WilNeeley/Mega2560_Fan_Controller/doc/hw_design_process.md

<!-- Improved compatibility of back to top link: See: https://github.com/othneildrew/Best-README-Template/pull/73 -->

<!--
*** Hey there, welcome to my README File. Here's a couple helpful resources for writing up files like this:
*** - VS Code is super hepful for previewing files like this (CTRL + Shift + V).
*** - Alternatively, Notepad++ has a few plugins (e.g. MarkdownViewer++) that can preview files. 
*** - GitHub documentation (good for the basics): https://docs.github.com/en/get-started/writing-on-github/getting-started-with-writing-and-formatting-on-github/basic-writing-and-formatting-syntax
*** - Best-README-Template (lets you do sophisticated things): https://github.com/othneildrew/Best-README-template/blob/main/README.md
-->

<!-- Logo and Title Section -->
<br />
<div align="center">
  <!-- <a><img src="./img/board_populated_circuitmaker_rendering.jpg" alt="Logo" width="400" height="500"></a> -->
  <h3 align="center"><strong>
    Mega2560 Fan Controller <br />    
    Hardware Design Process
  </strong></h3>
  
  <p align="center">
    Wil Neeley
    <br />
    2025-05-22
  </p>
</div>

## References

[ATmega2560 Datasheet](https://ww1.microchip.com/downloads/aemDocuments/documents/OTH/ProductDocuments/DataSheets/ATmega640-1280-1281-2560-2561-Datasheet-DS40002211A.pdf)

[Noctua PWM Specifications White Paper](https://noctua.at/pub/media/wysiwyg/Noctua_PWM_specifications_white_paper.pdf)

[Intel 4-Wire PWM Controlled Fans](https://www.intel.com/content/dam/support/us/en/documents/intel-nuc/intel-4wire-pwm-fans-specs.pdf)
