WilNeeley/Mega2560_Fan_Controller/img/v1/board_v1_bare_pcbway_rendering_bottom.png

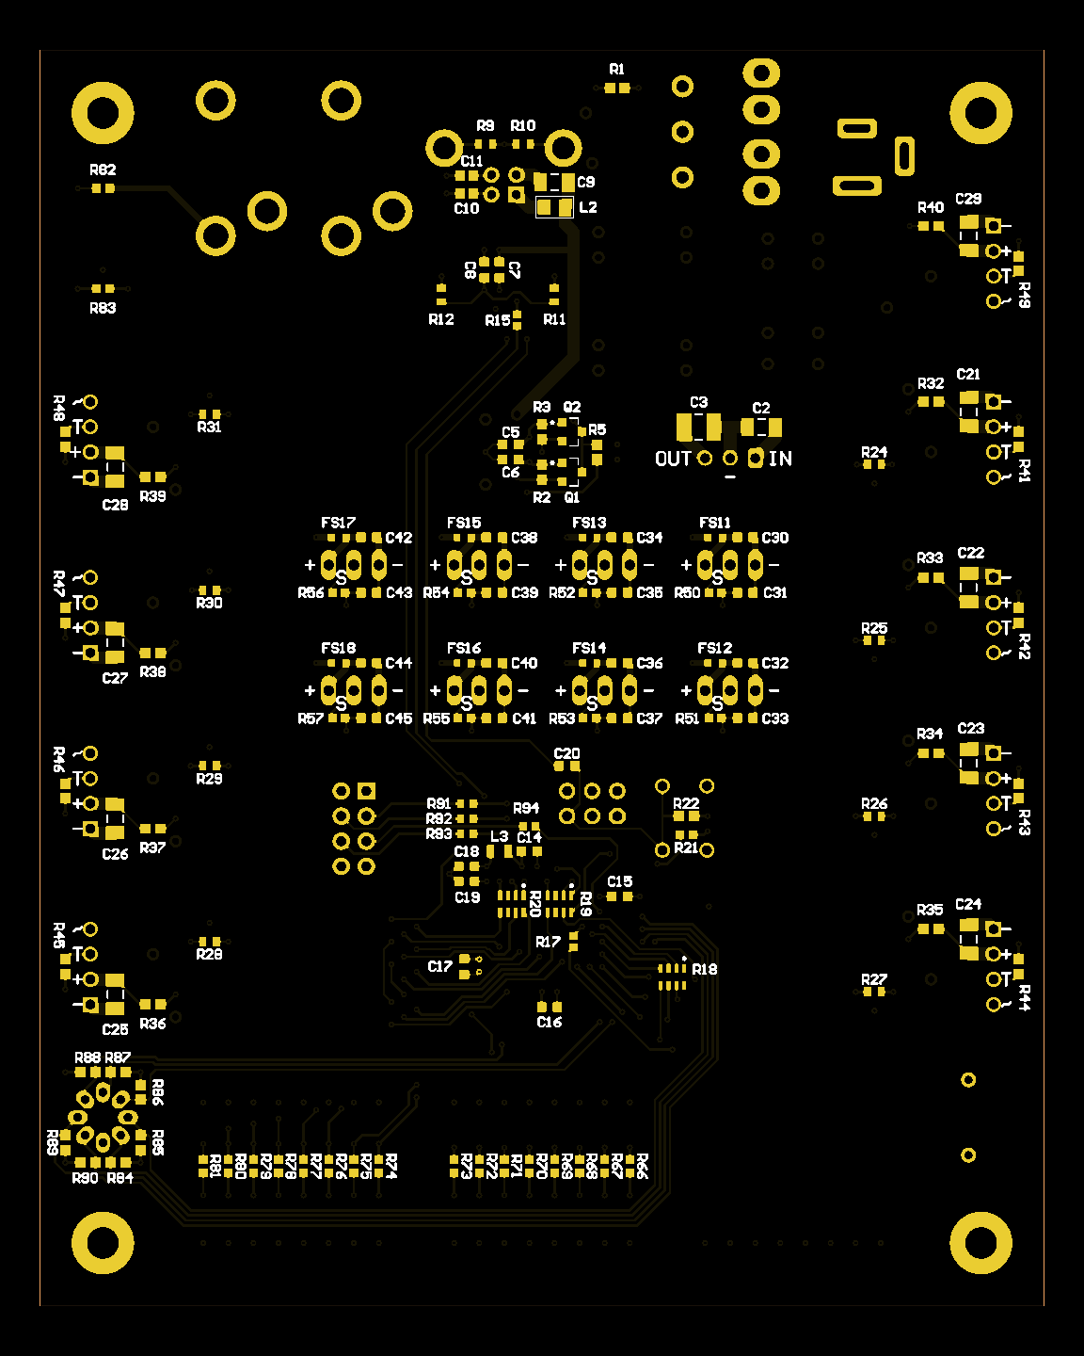
img/v1/board_v1_bare_pcbway_rendering_bottom.png
