WilNeeley/Mega2560_Fan_Controller/hw/v1/BOM - Mega2560 PWM Fan Controller v1.xlsx

Sheet: Summary
Parts | Unique | Type | Costs
On-Board Components
4 | 4 | Integrated Circuits | $26.39
90 | 7 | Resistors | $3.41
45 | 6 | Capacitors | $4.22
5 | 5 | Inductors, Crystals, and Oscillators | $2.23
49 | 4 | Diodes | $8.90
11 | 2 | Transistors | $11.03
27 | 10 | Connectors and Buttons | $26.75
19 | 4 | Miscellaneous | $7.15
250 | 42 | Total (no shipping) | $90.06
Off-Board Components
33 | 3 | Off-Board Components | $21.04
33 | 3 | Total (no shipping) | $21.04

Sheet: On-Board Components
Quantity | Reference Designator | Value | Package | Description | Manufacturer | Part # | AEC-Q? | RoHS? | Tmin (°C) | Tmax (°C) | Source | Source Part # | Cost | Extended | Notes
Integrated Circuits
1 | U1 | 5V | 3-SIP | NON-ISOLATED POL MODULE DC DC CO | GAPTEC | LME78_05-1.0 | Other (no) | Yes | -40 | 85 | Digi-Key | 3182-LME78_05-1.0-ND | $4.11 | $4.11
1 | U2 |  | 8-TSSOP | IC OR CTRLR SRC SELECT 8TSSOP | Texas Instruments | TPS2113PWR | No | Yes | -40 | 85 | Digi-Key | 296-46374-1-ND | $2.64 | $2.64
1 | U3 |  | 20-SSOP | IC USB SERIAL FULL UART 20SSOP | FTDI | FT231XS-R | No | Yes | -40 | 85 | Digi-Key | 768-1129-1-ND | $2.34 | $2.34
1 | U4 |  | 100-TQFP | IC MCU 8BIT 256KB FLASH 100TQFP | Microchip | ATMEGA2560-16AU | No | Yes | -40 | 85 | Digi-Key | ATMEGA2560-16AU-ND | $17.30 | $17.30
4 | Total | 4 | Unique Parts |  |  |  |  |  |  |  |  |  |  | $26.39
Resistors
1 | R23 | 1MEG | 0603 | RES SMD 1M OHM 1% 1/10W 0603 | Vishay Dale | CRCW06031M00FKEA | 200 | Yes | -55 | 155 | Digi-Key | 541-1.00MHCT-ND | $0.10 | $0.10
1 | R7 | 47k | 0603 | RES SMD 47K OHM 1% 1/10W 0603 | Vishay Dale | CRCW060347K0FKEA | 200 | Yes | -55 | 155 | Digi-Key | 541-47.0KHCT-ND | $0.10 | $0.10
32 | R1-R6, R22, R32-R49, R84-R90 | 10k | 0603 | RES SMD 10K OHM 1% 1/10W 0603 | Vishay Dale | CRCW060310K0FKEA | 200 | Yes | -55 | 155 | Digi-Key | 541-10.0KHCT-ND | $0.03 | $0.99
36 | R8, R21, R50-83 | 3k | 0603 | RES SMD 3K OHM 5% 1/10W 0603 | Vishay Dale | CRCW06033K00JNEA | 200 | Yes | -55 | 155 | Digi-Key | 541-3.0KGCT-ND | $0.03 | $1.04
12 | R9-R12, R24-R31 | 1.5k | 0603 | RES SMD 1.5K OHM 1% 1/10W 0603 | Vishay Dale | CRCW06031K50FKEA | 200 | Yes | -55 | 155 | Digi-Key | 541-1.50KHCT-ND | $0.03 | $0.37
3 | R18-R20 | 1k (x4) | 1206 (0603x4), Convex | RES ARRAY 4 RES 1K OHM 1206 | Bourns | CAY16-102J4LF | No | Yes | -55 | 125 | Digi-Key | CAY16-102J4LFCT-ND | $0.10 | $0.30
5 | R13-R17 | 27 | 0603 | RES SMD 27 OHM 1% 1/10W 0603 | Vishay Dale | CRCW060327R0FKEA | 200 | Yes | -55 | 155 | Digi-Key | 541-27.0HCT-ND | $0.10 | $0.50
0 | R91-R94 | DNI | 0603 | PLACEHOLDER | --- | --- | --- | --- | --- | --- | --- | --- | $0.00 | $0.00
90 | Total | 7 | Unique Parts |  |  |  |  |  |  |  |  |  |  | $3.41
Capacitors
1 | C1 | 680uF / 35V | 12.5mm (D) x 14mm (H) | CAP ALUM 680UF 20% 35V SMD | Panasonic | EEV-FK1V681Q | 200 | Yes | -55 | 105 | Digi-Key | PCE3465CT-ND | $1.45 | $1.45
2 | C3, C4 | 22uF / 16V | 1210 | CAP CER 22UF 16V X5R 1206 | Samsung | CL31A226MOCLNNC | No | Yes | -55 | 85 | Digi-Key | 1276-2728-1-ND | $0.23 | $0.46
11 | C2, C9, C20-C29 | 4.7uF / 50V | 1206 | CAP CER 4.7UF 50V X5R 1206 | Murata | GRM319R61H475KA12D | No | Yes | -55 | 85 | Digi-Key | 490-14384-1-ND | $0.13 | $1.47
27 | C5-C8, C14-C20, C30-C45 | 0.1uF / 16V+ | 0603 | CAP CER 0.1UF 50V X7R 0603 | Kemet | C0603C104K5RACTU | No | Yes | -55 | 125 | Digi-Key | 399-C0603C104K5RACTUCT-ND | $0.02 | $0.43
2 | C12-C13 | 18pF | 0603 | CAP CER 18PF 100V C0G/NP0 0603 | Murata | GCM1885C2A180JA16D | 200 | Yes | -55 | 125 | Digi-Key | 490-14762-1-ND | $0.10 | $0.20
2 | C10-C11 | 47pF | 0603 | CAP CER 47PF 100V C0G/NP0 0603 | Murata | GCM1885C2A470JA16J | 200 | Yes | -55 | 125 | Digi-Key | 490-GCM1885C2A470JA16JCT-ND | $0.10 | $0.20
45 | Total | 6 | Unique Parts |  |  |  |  |  |  |  |  |  |  | $4.22
Inductors, Crystals, and Oscillators
1 | BZ1 | 4kHz | 0.48" Dia. PTH | BUZZER PIEZO 3V 12.2MM TH | TDK Corporation | PS1240P02BT | No | Yes | -10 | 70 | Digi-Key | 445-2525-1-ND | $0.55 | $0.55
1 | L1 | 47uH / 2.95A | 12.5x12.5mm | FIXED IND 47UH 2.95A 71.9MOHM SM | Eaton | DR127-470-R | No | Yes | -40 | 125 | Digi-Key | 283-DR127-470-RCT-ND | $0.82 | $0.82
1 | L2 | 40 @ 100MHz | 0805 | FERRITE BEAD 40 OHM 0805 1LN | Laird | MI0805K400R-10 | No | Yes | -40 | 125 | Digi-Key | 240-2389-1-ND | $0.20 | $0.20
1 | L3 | 10uH | 0805 | FIXED IND 10UH 500MA 300MOHM SMD | TDK Corporation | MLZ2012N100LT000 | No | Yes | -55 | 125 | Digi-key | 445-6762-1-ND | $0.10 | $0.10
1 | X1 | 16MHz |  | CRYSTAL 16.0000MHZ 18PF SMD | Abracon | ABM3-16.000MHZ-D2Y-T | No | Yes | -40 | 85 | Digi-Key | 535-10638-1-ND | $0.56 | $0.56
5 | Total | 5 | Unique Parts |  |  |  |  |  |  |  |  |  |  | $2.23
Diodes
10 | D1-D10 | 12V | DO-214AA | TVS DIODE 12VWM 19.9VC DO214AA | Littelfuse | SMBJ12A | No | Yes | -65 | 150 | Digi-Key | SMBJ12ALFCT-ND | $0.21 | $2.15
21 | D11-D30, D49 | Green | 0603 | LED GREEN DIFFUSED 0603 SMD | Wurth Elektronik | 150060VS55040 | No | Yes | -40 | 85 | Digi-Key | 732-12017-1-ND | $0.17 | $3.63
9 | D31-D39 | Yellow | 0603 | LED YELLOW DIFFUSED 0603 SMD | Wurth Elektronik | 150060YS55040 | No | Yes | -40 | 85 | Digi-Key | 732-12018-1-ND | $0.17 | $1.56
9 | D40-D48 | Red | 0603 | LED RED DIFFUSED 0603 SMD | Wurth Elektronik | 150060SS55040 | No | Yes | -40 | 85 | Digi-Key | 732-12016-1-ND | $0.17 | $1.56
49 | Total | 4 | Unique Parts |  |  |  |  |  |  |  |  |  |  | $8.90
Transistors
9 | K1-K9 |  | 6-SOP | SSR RELAY SPST-NO 700MA 0-60V | Toshiba | TLP170AM(TPL,E | No | Yes | -40 | 85 | Digi-key | 264-TLP170AM(TPLECT-ND | $1.18 | $10.65
2 | Q1-Q2 |  | SOT-23-3 | MOSFET N-CH 100V 170MA SOT23-3 | Diodes Inc. | BSS123-7-F | No | Yes | -55 | 150 | Digi-Key | BSS123-FDICT-ND | $0.19 | $0.38
11 | Total | 2 | Unique Parts |  |  |  |  |  |  |  |  |  |  | $11.03
Connectors and Buttons
1 | J1 | 24V / 5A | 5.5x2.1mm barrel, PTH RA | CONN PWR JACK 2.1X5.5MM SOLDER | Wurth Elektronik | 694106301002 | No | Yes | -40 | 85 | Digi-Key | 732-5930-ND | $0.92 | $0.92
1 | J2 | USB 2.0 | USB-B, PTH, RA | CONN RCPT USB2.0 TYPEB 4POS R/A | Amphenol | 61729-0010BLF | No | Yes | -55 | 85 | Digi-Key | 609-1039-ND | $1.12 | $1.12
2 | J3, J4 | 12V / 1A | 3.5mm Mono, RA | CONN JACK MONO 3.5MM R/A | CUI Devices | MJ-3536NG | No | Yes | -40 | 85 | Digi-Key | CP-3536NG-ND | $1.27 | $2.54
0 | J5 |  | 6-PTH | CONN HEADER VERT 6POS 2.54MM | Harwin | M20-9980346 | No | Yes | -40 | 105 | Digi-Key | 952-2121-ND | $0.24 | $0.00
0 | J6 |  | 8-PTH | CONN HEADER VERT 8POS 2.54MM | Harwin | M20-9980446 | No | Yes | -40 | 105 | Digi-Key | 952-2123-ND | $0.31 | $0.00
9 | J11-J19 |  | 4-SIP | CONN HEADER VERT 4POS 2.54MM | Molex | 47053-1000 | No | Yes |  |  | Digi-Key | WM4330-ND | $0.41 | $3.73
8 | J21-J28 |  | 3-SIP | CONN HEADER VERT 3POS 2.54MM | Molex | 70543-0002 | No | Yes | -40 | 105 | Digi-Key | WM4801-ND | $0.93 | $7.44
1 | SW1 | 30V / 4A | 3-SIP | SWITCH SLIDE 1-POLE ON - ON | Knitter-Switch | MFP 106 D | No | Yes | -10 | 60 | Digi-Key | 3746-MFP106D-ND | $3.30 | $3.30
1 | SW2 | 30V / 50mA | 4-DIP | SWITCH TACTILE SPST-NO 0.05A 24V | TE Connectivity | 1825910-2 | No | Yes | -35 | 85 | Digi-Key | 450-1649-ND | $0.15 | $0.15
2 | SW3-SW4 | 20V / 100mA | 16-SOP | SWITCH SLIDE DIP SPST 0.1A 20V | CTS Electrocomponents | 219-8LPST | No | Yes | -55 | 85 | Digi-Key | CT2198LPST-ND | $1.00 | $2.00
1 | SW5 | 24V / 500mA |  | SWITCH ROTARY 7POS 500MA 24V | C&K Components | RM100772BCB | No | Yes | -40 | 85 | Digi-Key | CKN10691-ND | $4.62 | $4.62
1 | Cap for SW5 |  |  | RM SERIES CAP-TYPE B-BLK | C&K Components | 297F02000 | No | Yes | -40 | 85 | Digi-Key | CKN10707-ND | $0.92 | $0.92
27 | Total | 10 | Unique Parts |  |  |  |  |  |  |  |  |  |  | $26.75
Miscellaneous
1 | FS1 |  | Mini (ATM) | FUSE BLOCK BLADE 500V 20A PCB | Keystone | 3544-2 | No | Yes | -55 | 145 | Digi-Key | 36-3544-2-ND | $0.80 | $0.80
1 | Fuse for FS1 | 3A | Mini (ATM) | FUSE AUTOMOTIVE 3A 32VDC BLADE | Littelfuse | 0297003.WXT | Auto (no) | Yes | -40 | 125 | Digi-Key | 0297003.WXT-ND | $0.32 | $0.32
9 | FS2-FS10 | 0.5A | 1206 | FUSE BOARD MNT 500MA 63VDC 1206 | Bourns | SF1206S050-2 | No | Yes | -20 | 105 | Digi-Key | SF-1206S050-2CT-ND | $0.47 | $4.19
8 | FS11-FS18 | 10mA | 0603 | PTC RESET FUSE 60V 10MA 0603 | Bel Fuse | 0ZCM0001FF2G | 200 | Yes | -40 | 85 | Digi-Key | 5923-0ZCM0001FF2GCT-ND | $0.23 | $1.84
19 | Total | 4 | Unique Parts |  |  |  |  |  |  |  |  |  |  | $7.15
Selection Options
 |  |  |  |  |  |  | 100 | Yes
 |  |  |  |  |  |  | 101 | Exempt
 |  |  |  |  |  |  | 200 | ???
 |  |  |  |  |  |  | Aero. (no) | No
 |  |  |  |  |  |  | Auto (no)
 |  |  |  |  |  |  | IPXX (no)
 |  |  |  |  |  |  | Mili. (no)
 |  |  |  |  |  |  | Other (no)
 |  |  |  |  |  |  | No

Sheet: Off-Board Components
Quantity | Value | Package | Description | Manufacturer | Part # | AEC-Q200? | RoHS? | Tmin (°C) | Tmax (°C) | Source | Source Part # | Cost | Extended
1 |  |  | AC/DC WALL MOUNT ADAPTER 12V 36W | Mean Well | GST36U12-P1J | No | Yes | -30 | 70 | Digi-Key | 1866-2135-ND | $17.02 | $17.02
8 |  |  | Housings for J20-J27 Mates | Molex | 0050579403 | No | Yes | -40 | 105 | Digi-Key | WM2901-ND | $0.21 | $1.68
24 |  |  | Contacts for J20-J27 Mates | Molex | 0016020082 | No | Yes | -40 | 105 | Digi-Key | WM9138CT-ND | $0.10 | $2.34
33 | Total |  | 3 | Unique Parts |  |  |  |  |  |  |  |  | $21.04
Selection Options
 |  |  |  |  |  | 100 | Yes
 |  |  |  |  |  | 101 | Exempt
 |  |  |  |  |  | 200 | ???
 |  |  |  |  |  | Aero. (no) | No
 |  |  |  |  |  | Auto (no)
 |  |  |  |  |  | IPXX (no)
 |  |  |  |  |  | Mili. (no)
 |  |  |  |  |  | Other (no)
 |  |  |  |  |  | No
