WilNeeley/Mega2560_Fan_Controller/fw/FW_GETTING_STARTED.md

<!-- Improved compatibility of back to top link: See: https://github.com/othneildrew/Best-README-Template/pull/73 -->

<!--
*** Hey there, welcome to my RADME File. Here's a couple helpful resources for writing up files like this:
*** - VS Code is super hepful for previewing files like this (CTRL + Shift + V).
*** - Alternatively, Notepad++ has a few plugins (e.g. MarkdownViewer++) that can preview files. 
*** - GitHub documentation (good for the basics): https://docs.github.com/en/get-started/writing-on-github/getting-started-with-writing-and-formatting-on-github/basic-writing-and-formatting-syntax
*** - Best-README-Template (lets you do sophisticated things): https://github.com/othneildrew/Best-README-template/blob/main/README.md
-->

<!-- Logo and Title Section -->
<br />
<div align="center">
  
  <h3 align="center"><strong>
	Mega2560 Fan Controller
	<br />
	Hardware Documentation
	</strong>
  </h3>
  
  <p align="center">
    Wil Neeley
	<br />
	2025-05-12
	Board Version v1
  </p>
</div>

<!-- TABLE OF CONTENTS -->
<details>
  <summary>Table of Contents</summary>
  <ol>
    <li>
      <a href="#about-the-project">About The Project</a>
      <ul>
        <li><a href="#built-with">Built With</a></li>
      </ul>
    </li>
    <li>
      <a href="#getting-started">Getting Started</a>
      <ul>
        <li><a href="#prerequisites">Prerequisites</a></li>
        <li><a href="#installation">Installation</a></li>
      </ul>
    </li>
    <li><a href="#usage">Usage</a></li>
    <li><a href="#roadmap">Roadmap</a></li>
    <li><a href="#contributing">Contributing</a></li>
    <li><a href="#license">License</a></li>
    <li><a href="#contact">Contact</a></li>
    <li><a href="#acknowledgments">Acknowledgments</a></li>
  </ol>
</details>

<!-- ABOUT THE PROJECT -->
## About The Project

[![Product Name Screen Shot][product-screenshot]](https://example.com)

There are many great README templates available on GitHub; however, I didn't find one that really suited my needs so I created this enhanced one. I want to create a README template so amazing that it'll be the last one you ever need -- I think this is it.

Here's why:
* Your time should be focused on creating something amazing. A project that solves a problem and helps others
* You shouldn't be doing the same tasks over and over like creating a README from scratch
* You should implement DRY principles to the rest of your life :smile:

Of course, no one template will serve all projects since your needs may be different. So I'll be adding more in the near future. You may also suggest changes by forking this repo and creating a pull request or opening an issue. Thanks to all the people have contributed to expanding this template!

Use the `BLANK_README.md` to get started.

<p align="right">(<a href="#readme-top">back to top</a>)</p>

### Built With

This section should list any major frameworks/libraries used to bootstrap your project. Leave any add-ons/plugins for the acknowledgements section. Here are a few examples.

* [![Next][Next.js]][Next-url]
* [![React][React.js]][React-url]
* [![Vue][Vue.js]][Vue-url]
* [![Angular][Angular.io]][Angular-url]
* [![Svelte][Svelte.dev]][Svelte-url]
* [![Laravel][Laravel.com]][Laravel-url]
* [![Bootstrap][Bootstrap.com]][Bootstrap-url]
* [![JQuery][JQuery.com]][JQuery-url]

<p align="right">(<a href="#readme-top">back to top</a>)</p>
