WilNeeley/Mega2560_Fan_Controller/hw/v1/Schematic - Mega2560 PWM Fan Controller v1.pdf

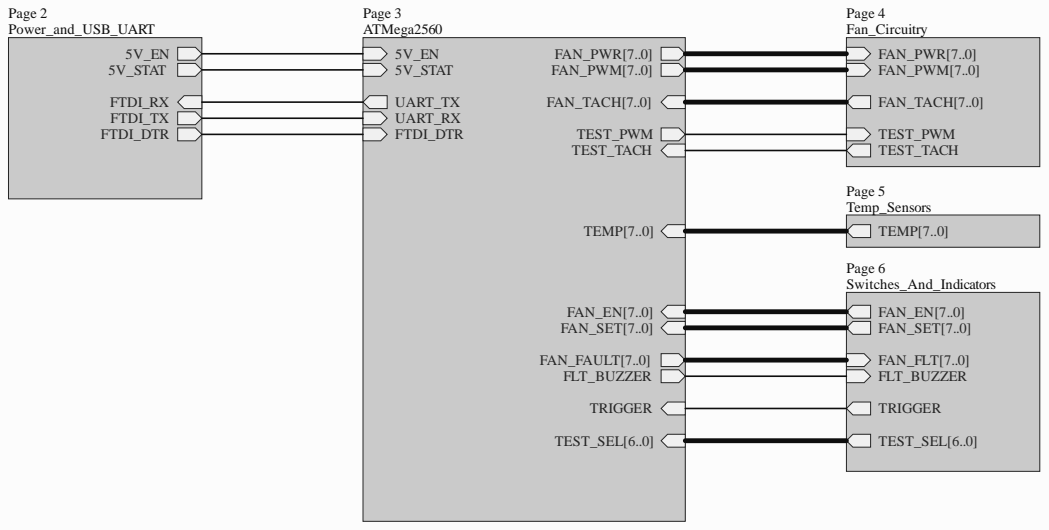
[picture p6: page 1]
SIZE; DWG NO.; FILE NAME; SHEET; CAGE CODE; REFERENCE DOCUMENTS; ASSY DWG:; FAB DWG:; PCB DWG:; PCBA-8 Fan PWM; Controller-[NO VARIATIONS] PROJECT REVISION:; DOCUMENT REVISION:; DESIGN ITEM:; Page 5; Page 6

DWG. NO. | A.3 REV. | 1 SHT.

THIS DOCUMENT AND THE DATA DISCLOSED HEREIN OR HEREWITH IS THE PROPERTY OF ALTIUM LIMITED AND MAY BE FREELY DISTRIBUTED IN WHOLE. NO RIGHTS ARE RESERVED OR EXPRESS OR IMPLIED WARANTEE GIVEN. | Page 2 Page 3 Page 4 Power_and_USB_UART ATMega2560 Fan_Circuitry | REVISION | DESCRIPTION | DATE | APPROVED

REV. SHT. DWG. NO.

DATE | PROJECT | * * APPROVALS * *

ENG: *

DSN: *

CHK: *

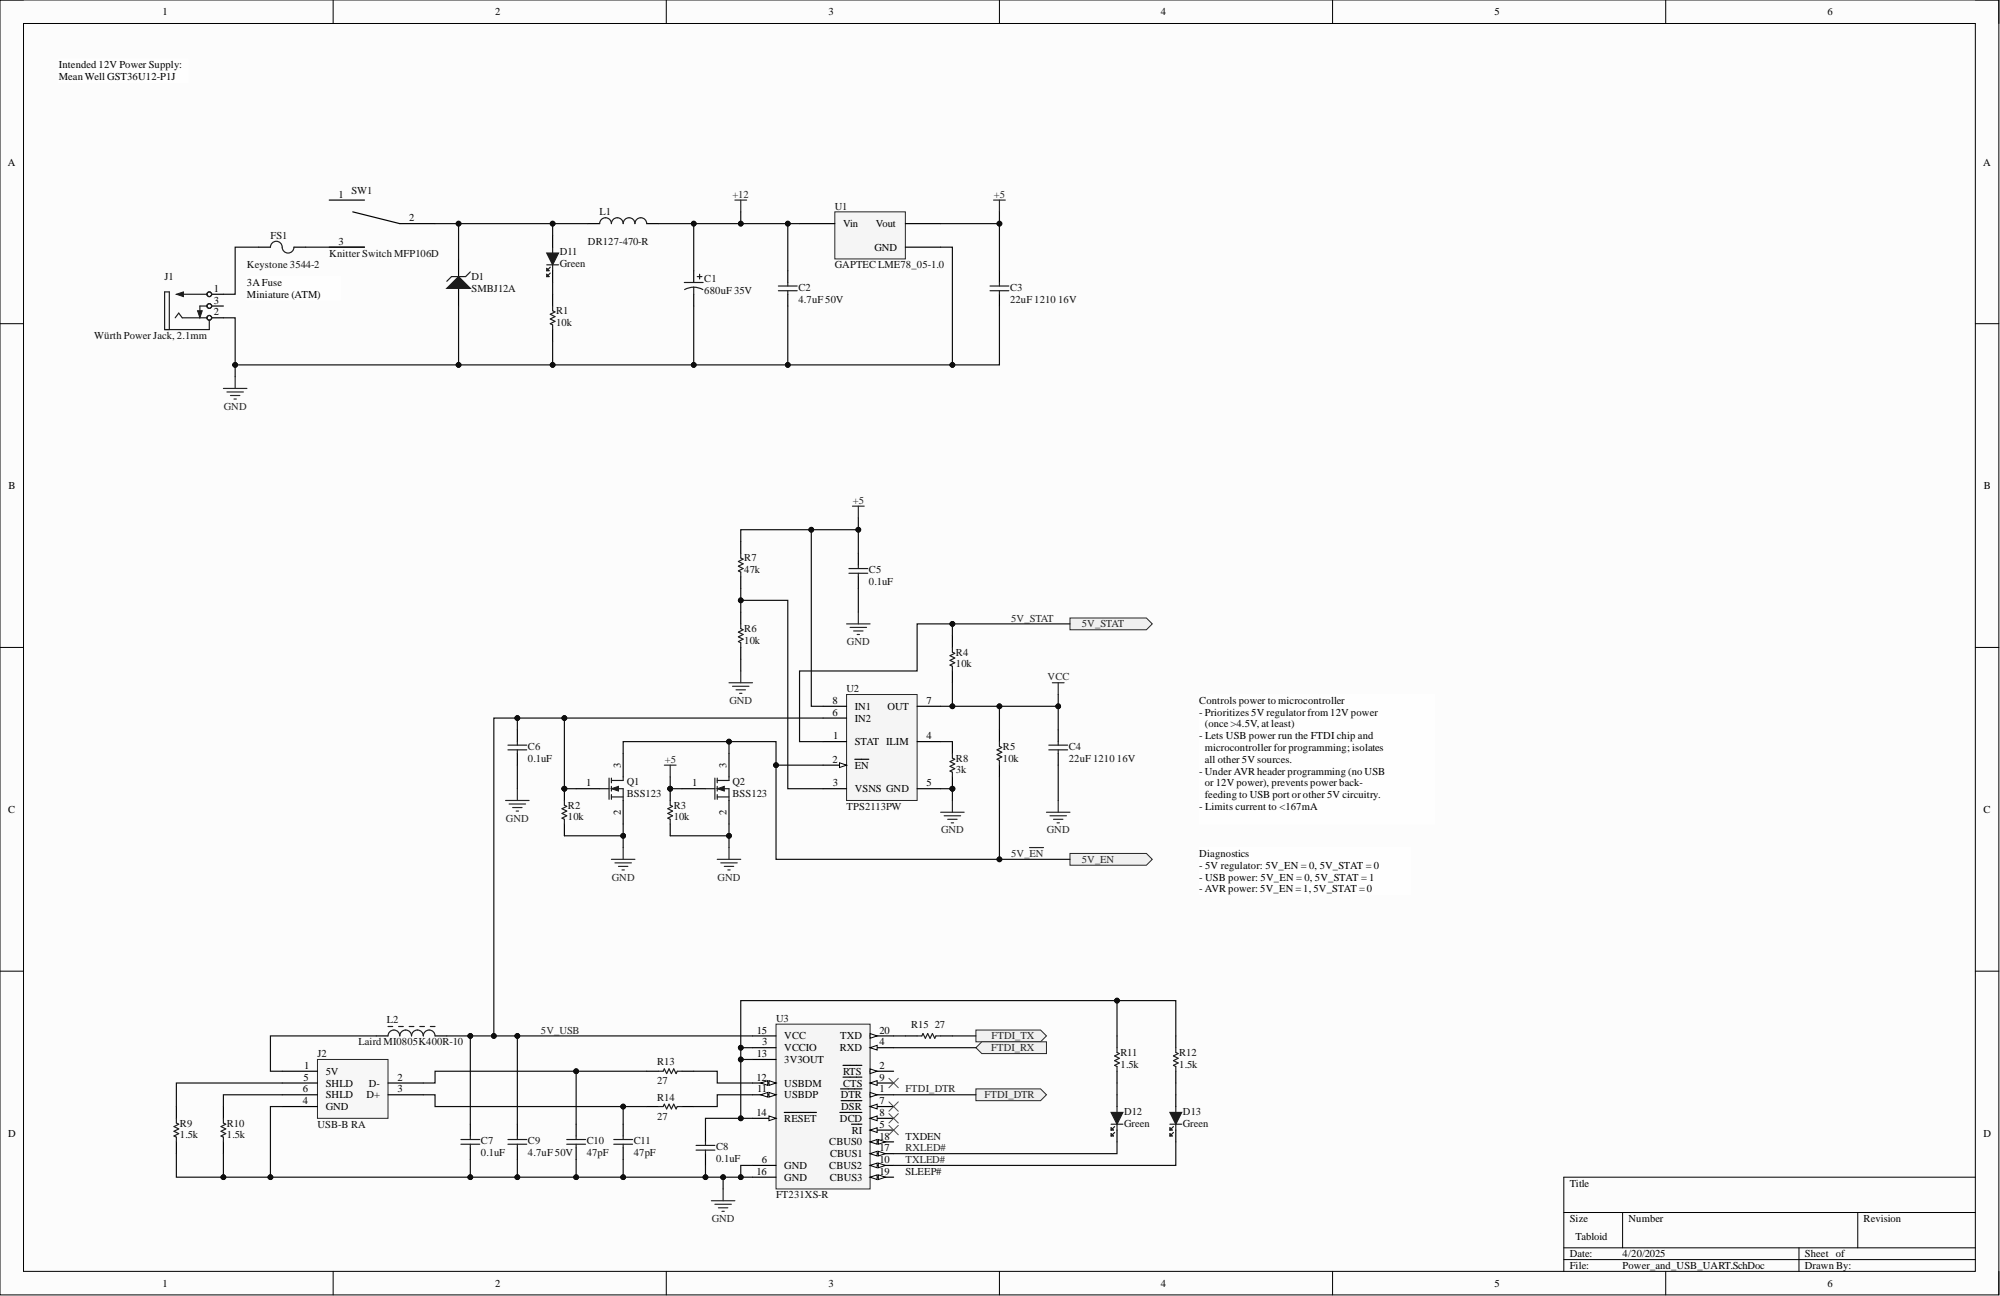
[picture p7: page 2]

Controls power to microcontroller
- Prioritizes 5V regulator from 12V power
(once >4.5V, at least)
- Lets USB power run the FTDI chip and
microcontroller for programming; isolates
all other 5V sources.
- Under AVR header programming (no USB
or 12V power), prevents power back-
feeding to USB port or other 5V circuitry.
- Limits current to <167mA

STAT 1

VSNS 3

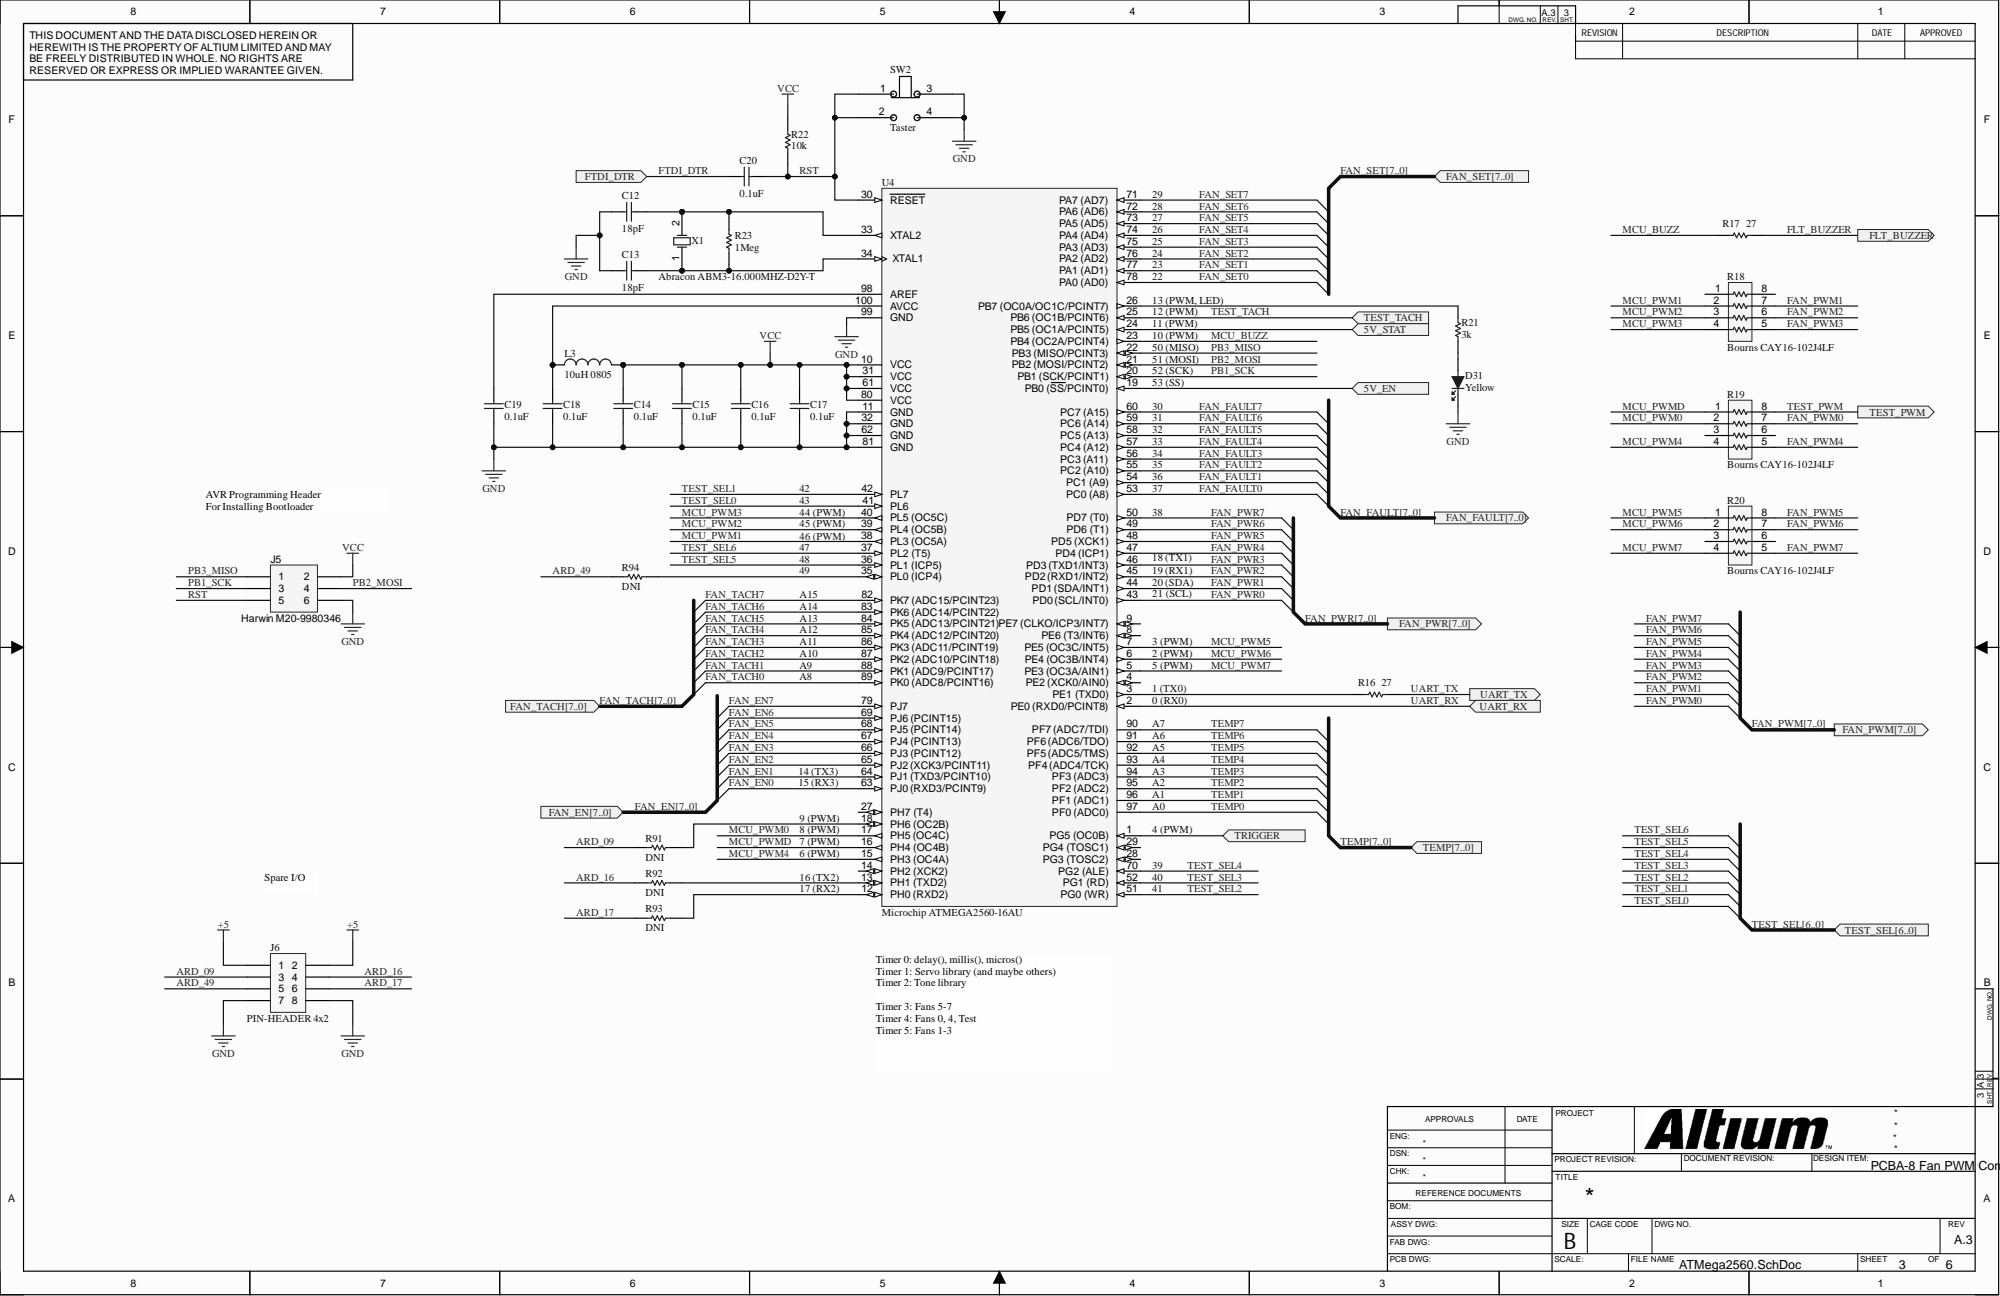
[picture p8: page 3]

DWG . N O . | A. R E V . | S H T.

T H IS DOC U MEN T AN D T HE ATA ISCLOSED HEREI N OR HEREW I T H IS T HE PROPER TY OF ALT I U M LI M I TED AN M AY BE F REELY IST R IBU TED I W HOLE. NO R IGH TS ARE RESERVED OR EXPRESS OR I MPLIED WARAN TEE GIVEN . | SW | REVISI ON | DESCRIPTI O N | DATE | APPROVED

6 (PWM) 7 (PWM) 8 (PWM) 9 (PWM) 15 (RX3) 14 (TX3) A8 A9 A10 A11 A12 A13 A14 A15 424344 (PWM) 45 (PWM) 46 (PWM) 474849

3 (PWM) 2 (PWM) 5 (PWM) 1 (TX0) 0 (RX0) A7 A6 A5 A4 A3 A2 A1 A0 4 (PWM) 3940

REV. SHT. DWG. NO.

DATE | PRO JECT | **** APPROVALS

ENG :
** DSN:

CHK: *

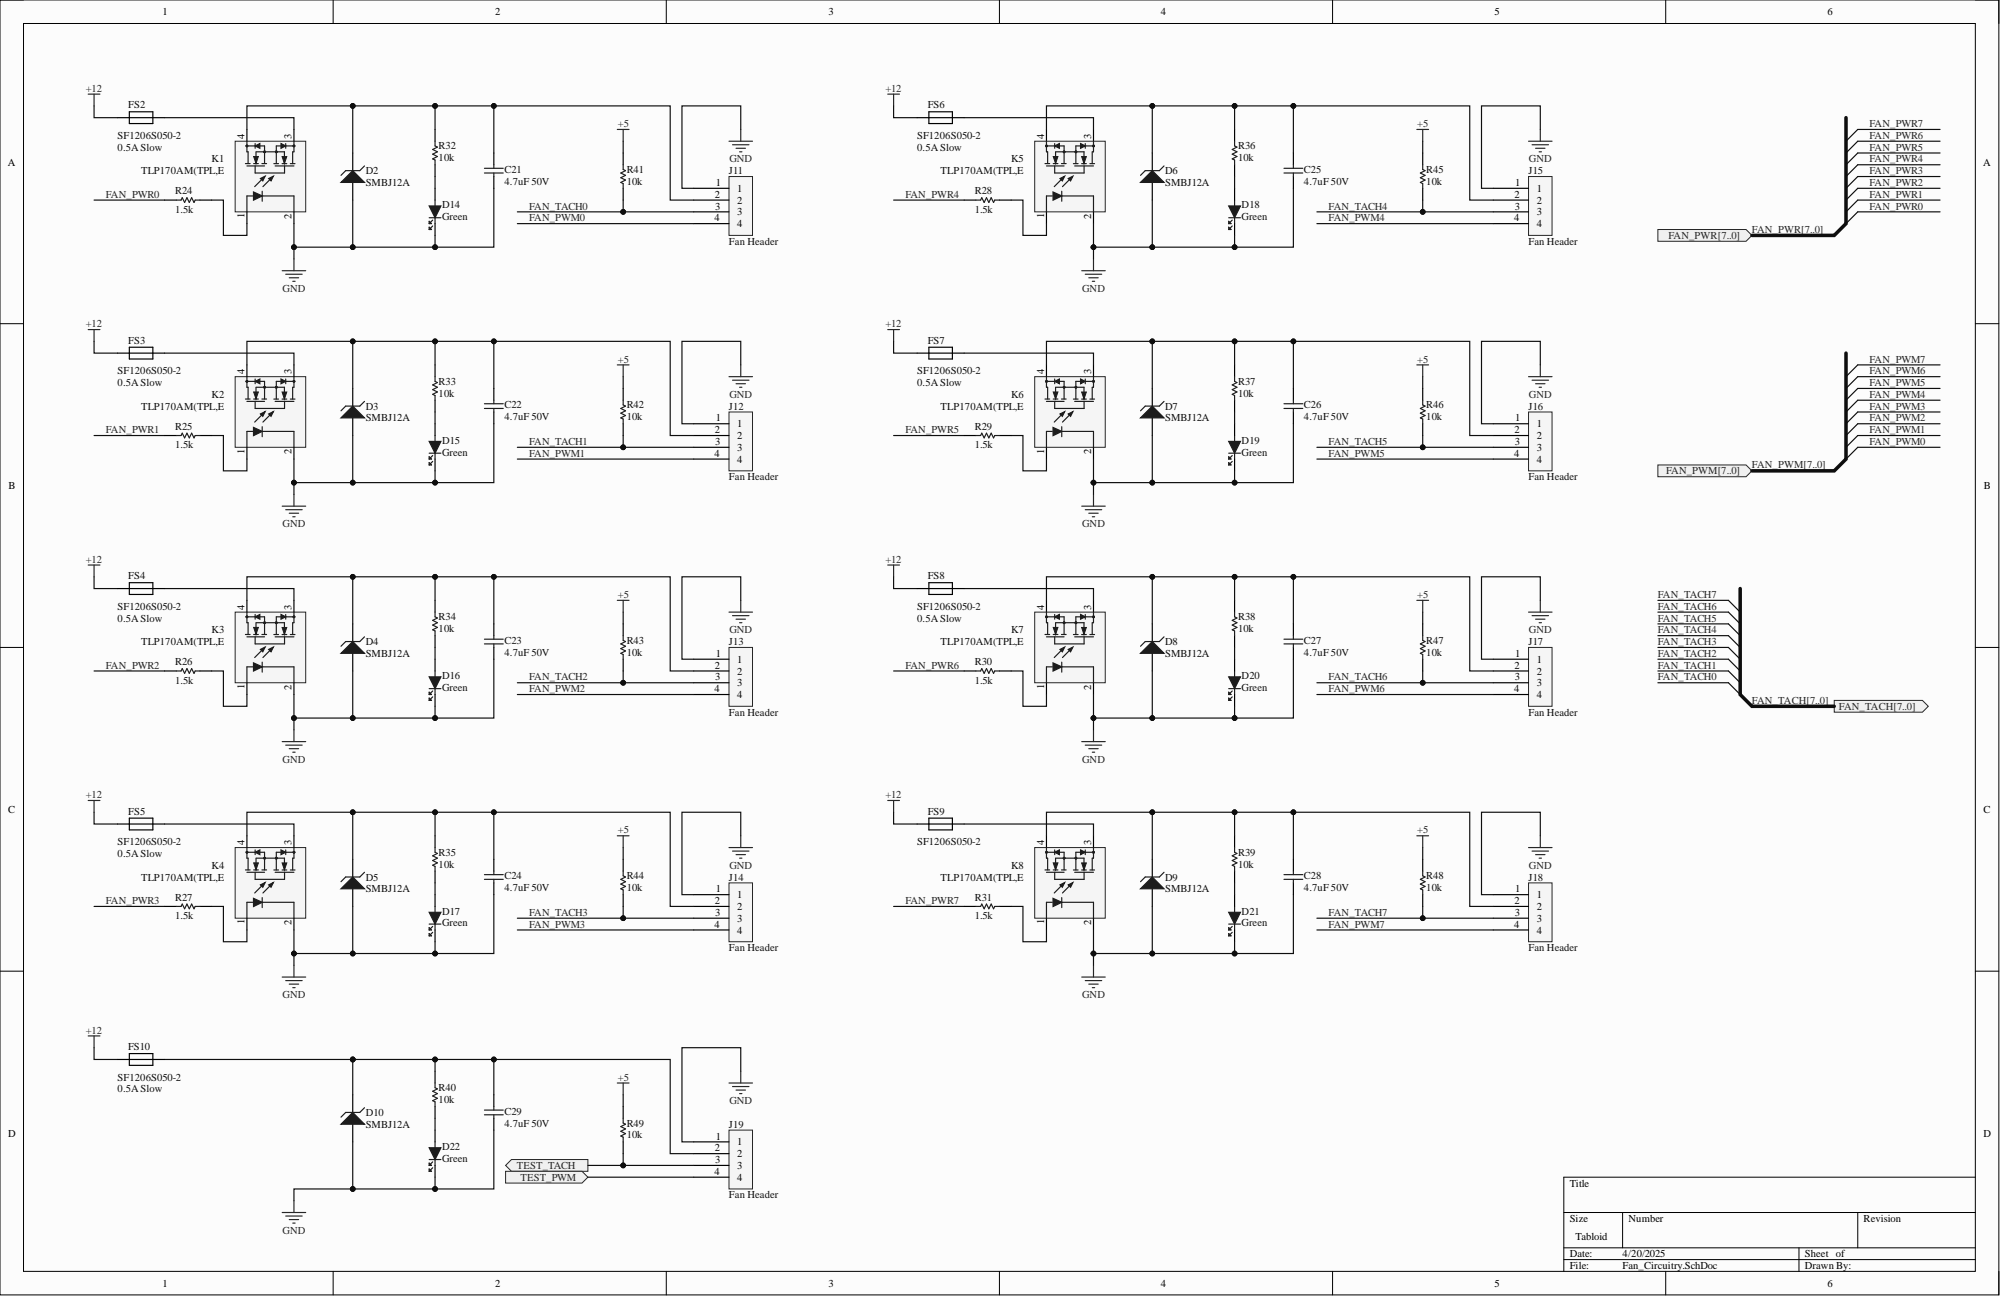
[picture p9: page 4]

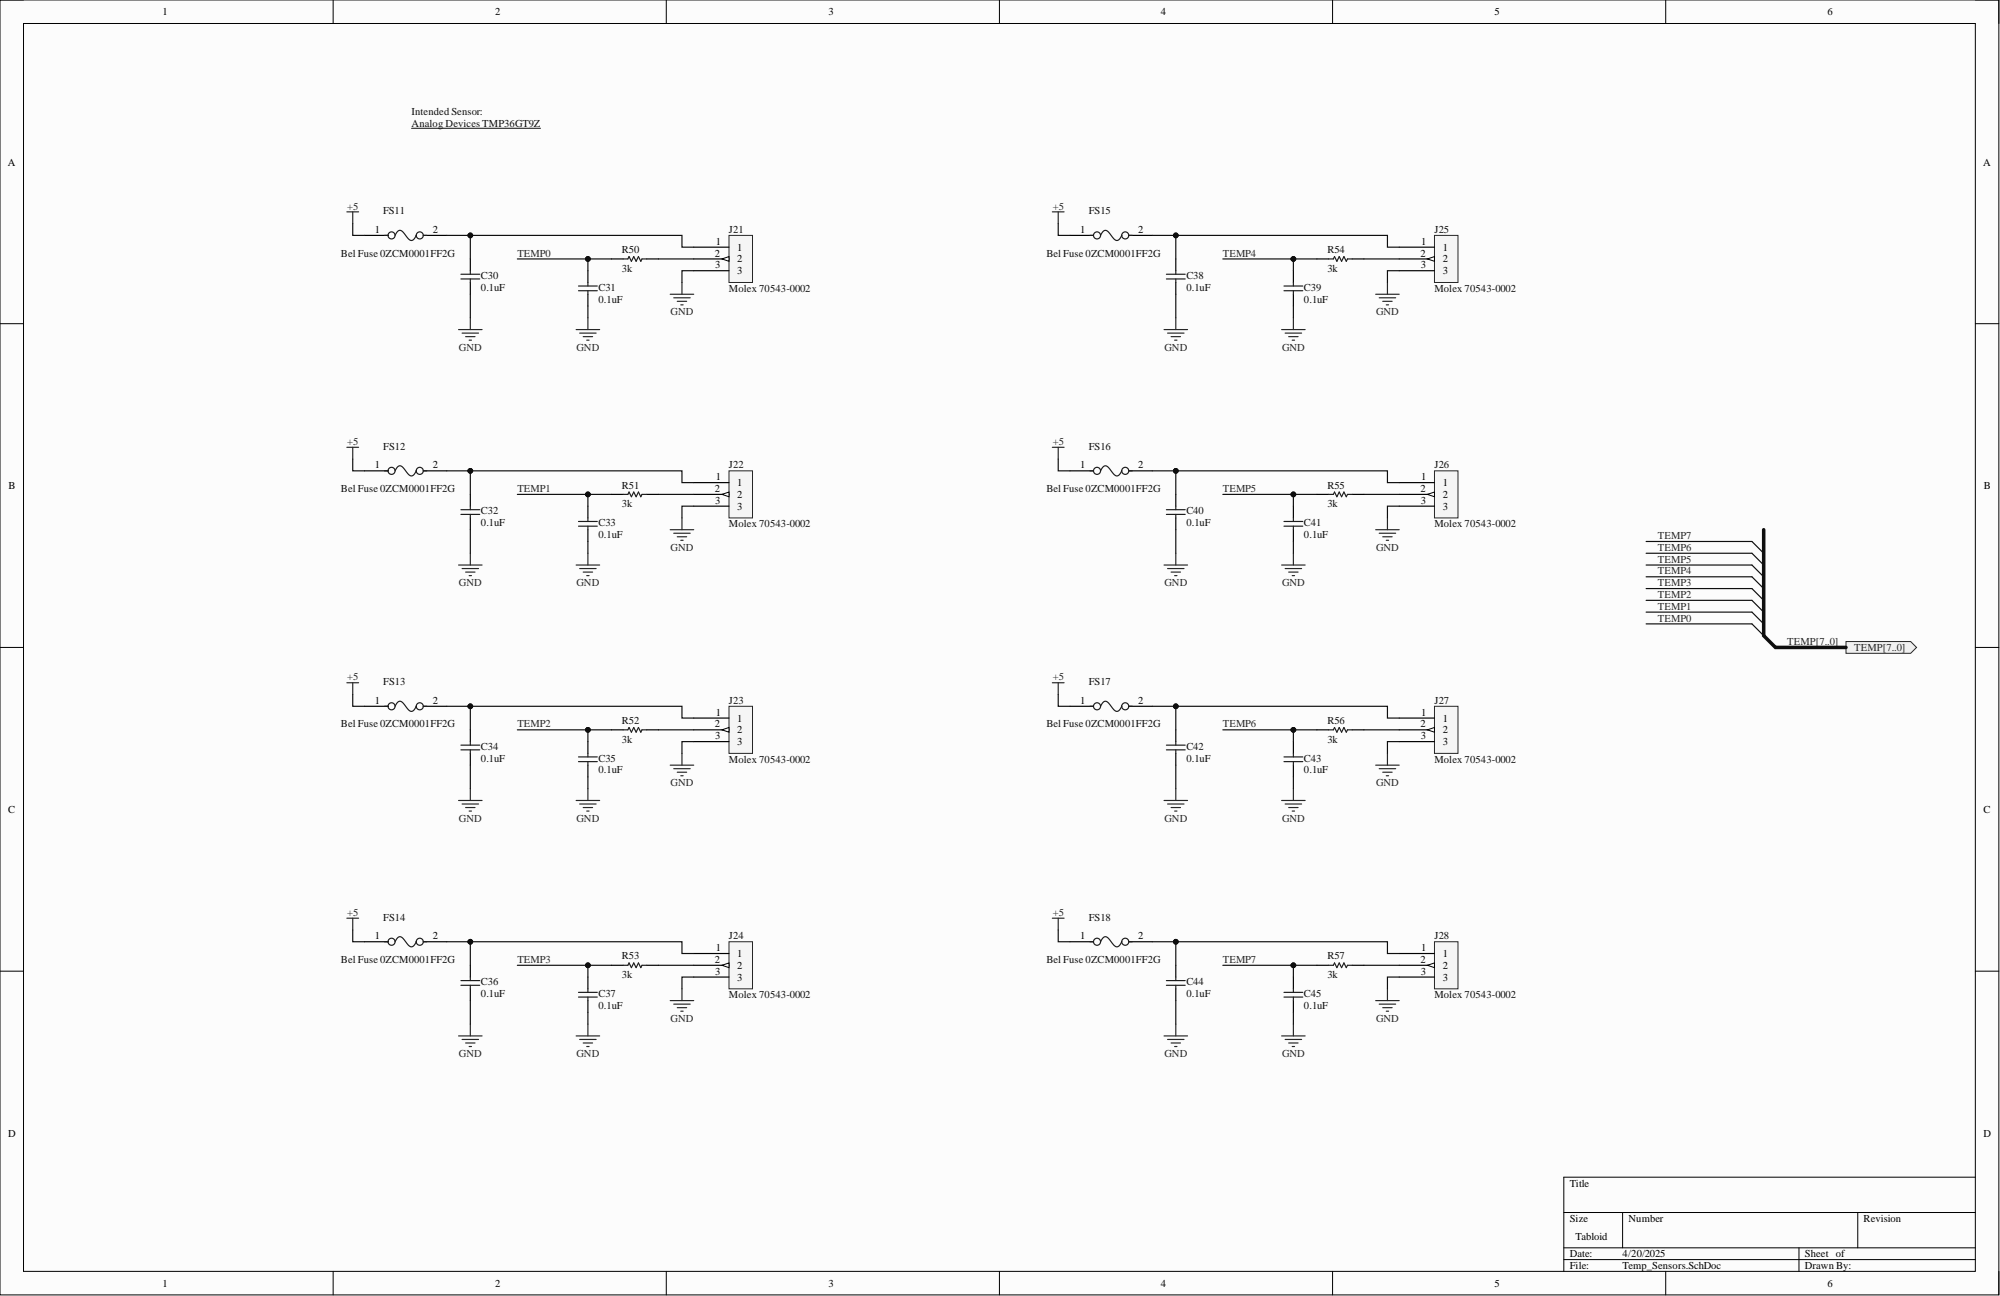
[picture p10: page 5]
ded Sen; Bel Fu

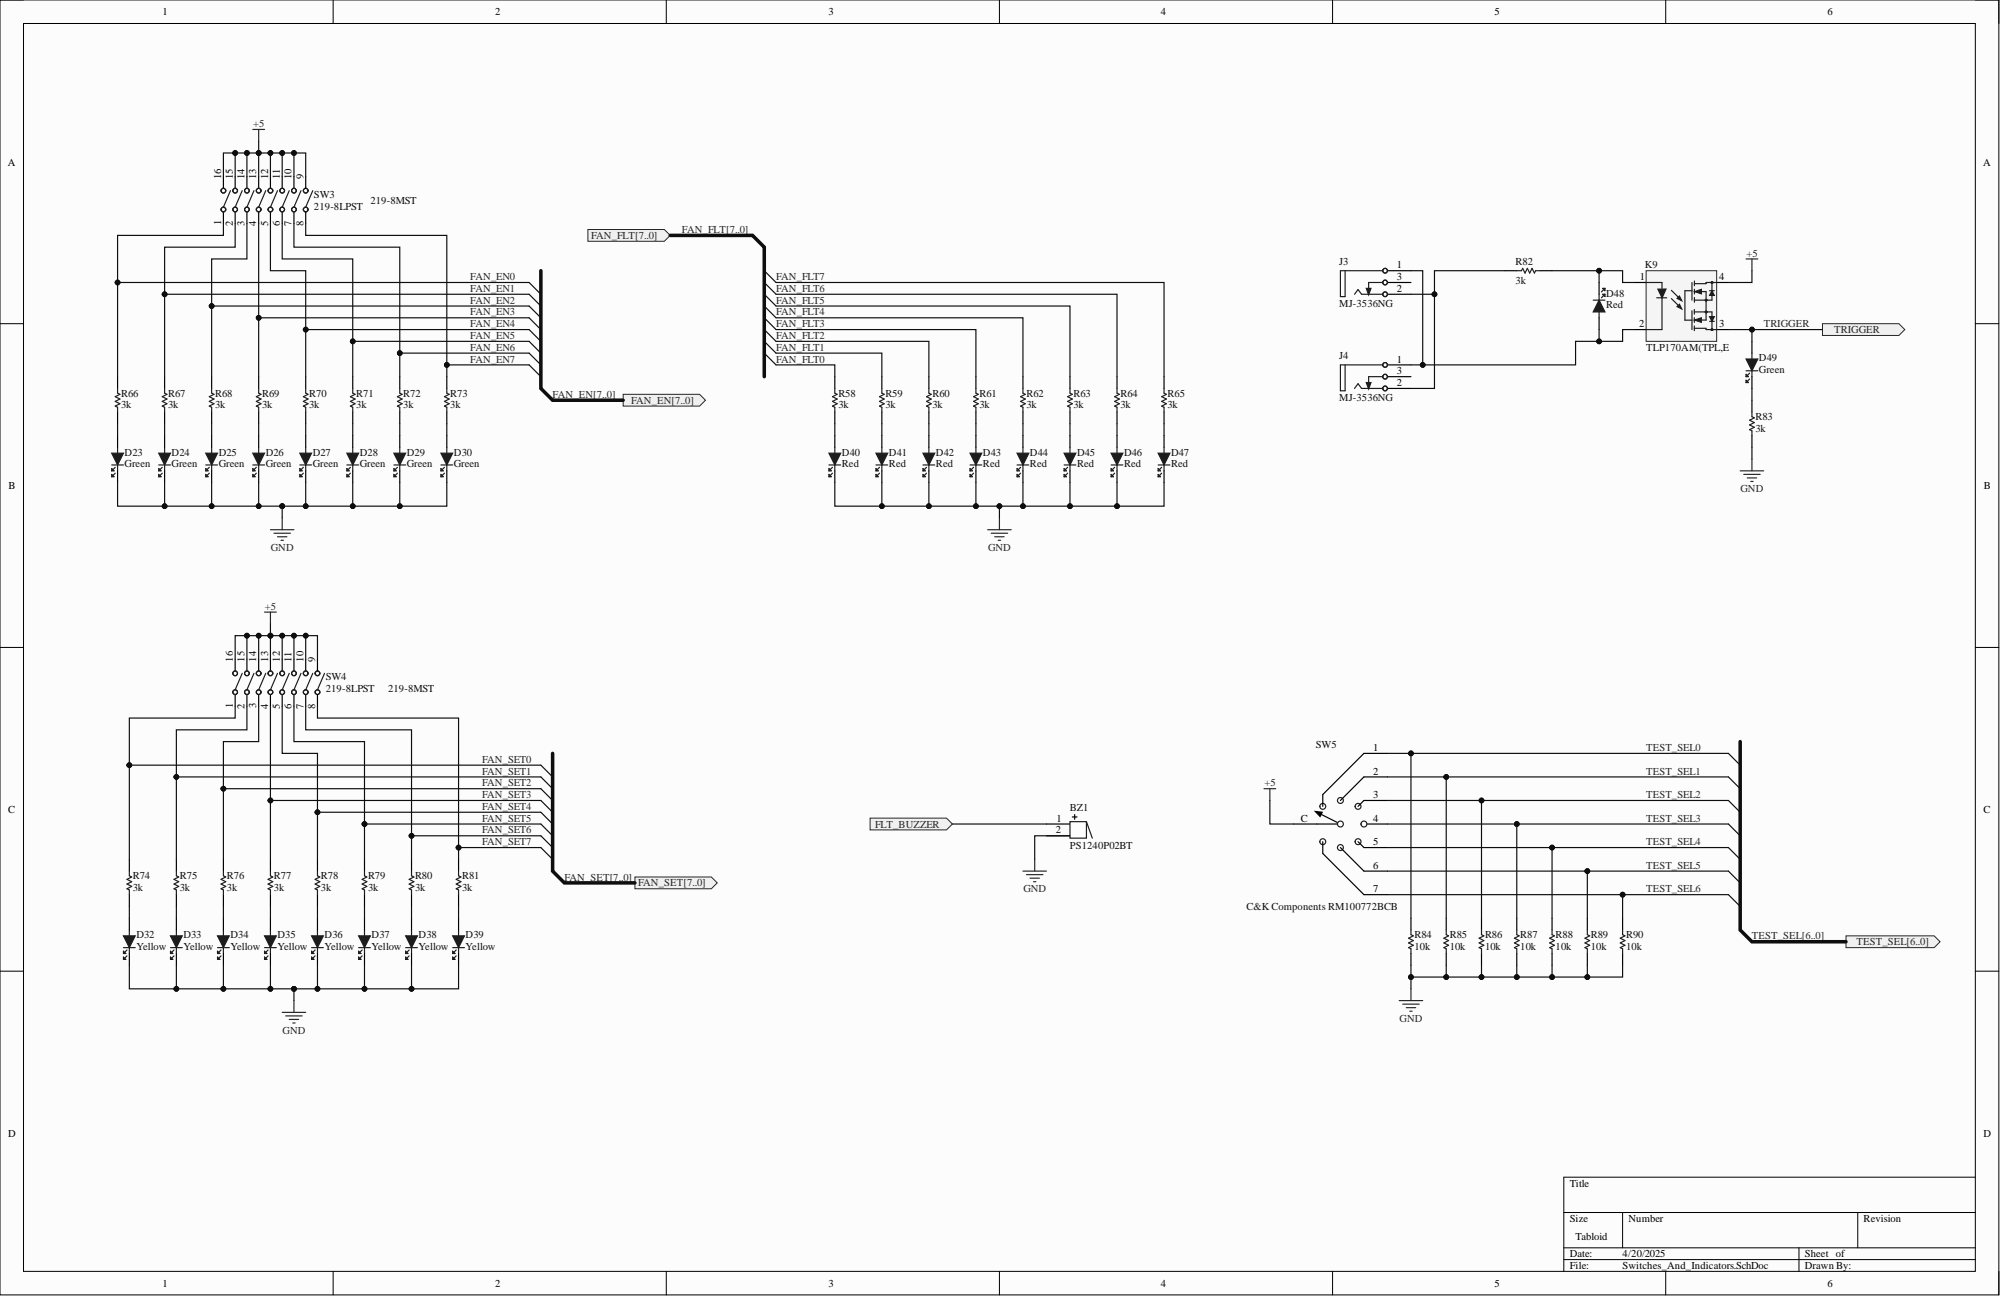
[picture p11: page 6]

FAN_SET1
FAN_SET2
FAN_SET3

FAN_SET5
FAN_SET6
FAN_SET7

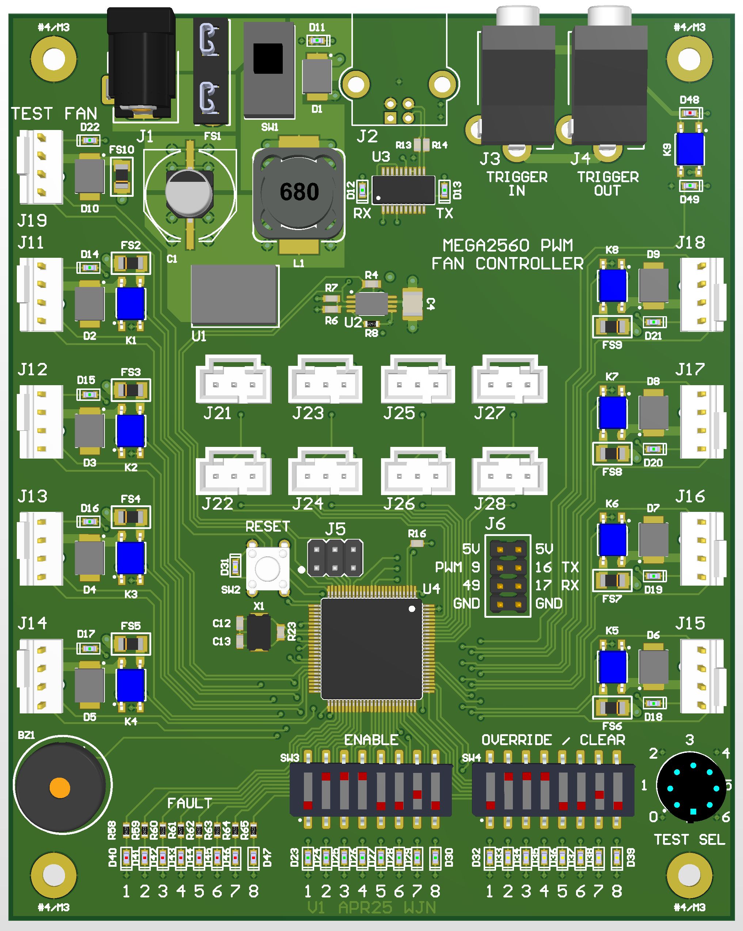
[picture p12: page 7]
