WilNeeley/Mega2560_Fan_Controller/(commit log)

2025-05-13 Adding Baseline Files
    - Updated README file with better formatting; still a lot of work to do
    - Created Getting Started files for both hardware and software. Not much to them right now.
    - Added v1 Board Files
    - Started typedefs and pindefs
    [BOM - Mega2560 PWM Fan Controller v1.xlsx]
2025-05-13 Updated pindefs.h
    Incorporated single pin definitions and left placeholders for port definitions.
2025-05-18 Added Hardware Inspection Instructions
    Created a Markdown file with hardware inspection instructions, and moved any revision-specific board photos to their own folder in the "img" folder.
2025-05-20 Finished Arduino Bootloader, Adding Test Sketches
    Finished documenting how to upload the Arduino bootloader, and started adding info on board hardware evaluation sketches.
2025-05-22 Added Switches and More LEDs test sketch
    Validates multiple inputs and outputs are working as expected.
2025-05-22 Power Monitor
2025-05-29 Added temperature sensor test sketch + documentation
2025-05-31 Changed temperature sensor management to be class-based for simplicity
2025-06-03 Created Fan Control sketch; still have some kinks to iron out, but I've got crude fan speed control!
2025-06-05 Fixed FanControl Class and Started Tachometer Sketch
    [07_fan_tachometer_test.ino, FanControl.cpp, FanControl.h, pindefs.h]
